keep-hueggede/ESP12-BME/(commit log)

2024-02-07 add struct for bme280, measure voltage to detect low batteries
2025-09-09 rearrange for esp32h2 - sketch is building
2026-09-01 snapshot: pick up current working tree before Matter port
2026-09-01 refactor: scaffold ESP-IDF project for Matter over Thread
    Replace the Arduino-only ESP-NOW sketch with an ESP-IDF + Arduino core
    (Arduino-as-IDF-component) project structure as recommended by Espressif
    for Matter over Thread on ESP32-H2:
    - CMakeLists.txt, main/ scaffold for the Matter/OpenThread build
    - sdkconfig.defaults: OpenThread, BLE commissioning, light sleep, no Wi-Fi
    - partitions.csv for the 4MB Thread/Matter flash layout
    - drop the old ESP-NOW payload structs and .ino sketch
    [partitions.csv]
2026-09-01 feat: add Matter weather station node (temp/humidity/pressure + wind/rain)
    New Arduino-as-IDF sketch that reads the BME280 (temperature, humidity,
    pressure) as standard Matter sensor endpoints and publishes wind speed and
    rain amount through a vendor custom cluster (0x131BFC01) on a dedicated
    endpoint. The BME280 / anemometer / rain-gauge reading code is kept from the
    original sketch. Commissioning happens over BLE with the manual pairing code
    or QR code shown on the serial console.
2026-09-01 docs: document Matter over Thread workflow and data model
    Rewrite README: hardware/pinout, the BME280 + wind/rain sensor mappings
    (standard Matter endpoints vs. vendor custom cluster), ESP-IDF build steps,
    BLE commissioning into a Thread network, and the power-saving notes.
2026-09-01 fix: align custom cluster and power management with real esp-matter API
    Verified against the esp-matter/IDF headers:
    - use generic esp_pm_config_t (esp_pm_config_esp32h2_t does not exist)
    - attribute::update() takes (endpoint_id, cluster_id, attribute_id, val),
    so track the custom endpoint id and drop the invalid attr->cluster use
    - pass priv_data explicitly to endpoint::create()
2026-09-01 refactor: drop Matter/ESP-IDF variant for a plain Arduino approach
    Decision: Matter (with its custom cluster + ESP-IDF build requirements) is
    overkill for this battery-minded weather node that only needs to ship data to
    a database via a Thread border router. Remove the ESP-IDF + Arduino-as-IDF
    scaffold and Matter sketch; the next commits reintroduce a clean Arduino-IDE
    sketch using plain Thread + CoAP.
    [partitions.csv]
2026-09-01 feat: plain Arduino Thread + CoAP weather node
    Reintroduce the weather station as a single Arduino-IDE sketch. The node
    joins the Thread network (operational dataset, easily editable THREAD_*
    constants) and exposes the sensor readings as CoAP resources on udp/5683:
    /weather/all JSON with temp, pressure, humidity, wind, rain
    /weather/temp text
    /weather/pressure text
    /weather/humidity text
    Respects OThreadCoAPServer's 4-resource default (OT_COAP_MAX_RESOURCES), so
    wind/rain are served via the /weather/all JSON endpoint. README updated to
    document the Thread border router topology, Arduino IDE build, and setup.
2026-09-01 feat: restore SensorStruct.h and use struct for sampled data
    Reintroduce the original bme280Struct (t, p, alt, hum, wSpeed) from the
    pre-Matter sketch. Sampling is back to the original readSensors()/sampleData()
    pattern: each sensor set lands in a SensorStruct, SAMPLING_COUNT values are
    averaged into a global bme280Struct 'meanVals', and loop() publishes those
    values to the CoAP resources. The old ESP-NOW-specific ComStruct stays
    dropped (ESP-NOW was removed with the Matter port).
2026-09-01 docs: add wiring diagram, fix anemometer pin to ADC1_CH0/GPIO1
    Add Schaltplan.md with pin table, ASCII block wiring diagram, power notes
    and optional voltage-divider for the anemometer.
    Correct the anemometer GPIO in code comment and README: ADC1_CH0 on the
    ESP32-H2 is GPIO1 (GPIO36 only exists on the classic ESP32). The code
    always resolved ADC1_CH0 correctly; only the documentation was wrong.
    [ESP-BME.ino]
2026-09-01 docs: make wiring plan board-specific for Waveshare ESP32-H2-Zero
    Verified against the board pinout: GPIO1 (ADC1_CH0), GPIO4/GPIO5 (I2C) and
    GPIO12 (rain gauge) are all available on the left header of the ESP32-H2-Zero;
    no conflict with RGB LED (GPIO8), BOOT (GPIO9) or UART (GPIO23/24). Add the
    board header table, 5V/USB power note and 3.3V-only warning to Schaltplan.md.
2026-09-01 fix: use GPIO1 for analogRead instead of ADC1_CH0
    ADC1_CH0 is an ESP-IDF macro that is not defined in the arduino-esp32 core,
    which caused 'ADC1_CH0' was not declared in this scope' during compilation.
    analogRead() takes a GPIO number on arduino-esp32, so use GPIO1 (which IS the
    ADC1_CH0 pin on the ESP32-H2). Update the wiring-doc note accordingly.
    [ESP-BME.ino]
2026-09-01 fix: use integer pin number 1 for analogRead on ESP32-H2
    Both ADC1_CH0 and GPIO1 are not defined as macros in the arduino-esp32
    core. analogRead() expects a plain integer pin number. Use literal 1
    (analogRead(1) == ADC1_CH0 on ESP32-H2). Compilation verified via
    arduino-cli 1.5.2.
    [ESP-BME.ino]
2026-09-01 feat: add I2C scan diagnostic when BME280 not found
    If bme.begin(0x76) fails, scan the whole I2C bus and print every address
    present instead of silently hanging. Confirmed via serial that GPIO4/GPIO5
    currently report 0 devices, isolating the issue to wiring/hardware rather
    than the sketch.
    Also note: build must use CDCOnBoot=cdc so Serial goes to the Waveshare
    ESP32-H2-Zero's native USB-Serial/JTAG (no USB-UART bridge; default board
    config routes Serial to UART0/GPIO23-24).
    [ESP-BME.ino]
2026-09-01 fix: detect BME280 at real pins (SDA=GPIO5, SCL=GPIO4) and addr 0x77
    Bus scan proved the module answers at SDA=GPIO5/SCL=GPIO4 (mirror block
    each other compared to the old defines) with I2C address 0x77 (SDO high).
    Update defines, wiring docs (README, Schaltplan) accordingly and keep a
    single-address scan only for the failure case.
    Serial now confirms: BME280 found, sketch proceeds to Thread join which
    times out as expected (no OTBR/network dataset yet).
    [ESP-BME.ino]
2026-09-01 feat: join Wetter-Thread as client (network-key only), disable LED, print EID + value table
2026-09-02 feat: replace Thread/CoAP with LoRa (SX127x) forest sender, 868 MHz SF12
    [ESP-BME.ino]
